TeoMouse/Electronic-Load-Project/3_ProductionFiles/BOM/Bill of Materials-Electronic_Load(Variant1).xlsx

Line # | Name | Description | Designator | Quantity | Value | Manufacturer 1 | Manufacturer Part Number 1 | Supplier Part Number 1
 | C0402 | Capacitor | C1_1, C1_2, C1_3, C1_4, C1_5, C1_6, C6_1, C6_2, C6_3, C6_4, C6_5, C6_6, C7_1, C7_2, C7_3, C7_4, C7_5, C7_6, C8_1, C8_2, C8_3, C8_4, C8_5, C8_6, C9_1, C9_2, C9_3, C9_4, C9_5, C9_6, C10, C18, C20, C21, C22, C24, C25, C26, C27, C31, C33, C36, C38, C39, C40, C41, C42, C43, C46 | 49 | 100nF/50V
 | C0402 | Capacitor | C4_1, C4_2, C4_3, C4_4, C4_5, C4_6, C14, C15, C16, C17 | 10 | 1uF/25V
 | C1206 | Capacitor | C11 | 1 | 2.2uF/100V
 | C0805 | Capacitor | C12, C13 | 2 | 22uF/25V
 | C0402 | Capacitor | C19 | 1 | 220pF/50V
 | C0603 | Capacitor | C23, C28, C29, C30, C32 | 5 | 10uF/25V
 | C0402 | Capacitor | C34, C35 | 2 | 12pF/25V
 | C0402 | Capacitor | C37 | 1 | 10nF/50V
 | C0805 | Capacitor | C44 | 1 | 100nF/50V
 | C0402 | Capacitor | C45 | 1 | 100pF/50V
 | V | LED | D2 | 1 |  | Wurth Electronics | 150060GS75000 | 710-150060GS75000
 | Schottky | Schottky Diode | D3 | 1 | S110FA |  |  | 512-S110FA
 | 100Ohms |  | FB1, FB2 | 2 |  | Wurth Electronics | 742792620 | 710-742792620
 | 74404064680 | Inductor 68 uH 1A Wurth Elektronic | L1 | 1 |  | Wurth Electronics | 74404064680 | 710-74404064680
 | Con 2x5.08 mm Screw |  | P1, P2 | 2
 | 1x2 2.54mm Straight Con |  | P3, P4, P5, P6, P7, P8, P9 | 7 |  | Eaton | NRL1104J3435B2F | 504-NRL1104J3435B2F
 | Screw_Pad_3mm |  | P10, P11 | 2
 | TO-247 Mos | MOSFET (N-Channel) | Q1_1, Q1_2, Q1_3, Q1_4, Q1_5, Q1_6 | 6 |  | Infineon | IRFP150NPBF | 942-IRFP150NPBF
 | PMV450ENEAR | MOSFET (N-Channel) | Q2 | 1 |  | Nexperia | PMV450ENEAR | 771-PMV450ENEAR
 | R0402 | Resistor | R1_1, R1_2, R1_3, R1_4, R1_5, R1_6, R12_1, R12_2, R12_3, R12_4, R12_5, R12_6, R14_1, R14_2, R14_3, R14_4, R14_5, R14_6, R18, R24, R56 | 21 | 1k
 | R0402 | Resistor | R2_1, R2_2, R2_3, R2_4, R2_5, R2_6, R3_1, R3_2, R3_3, R3_4, R3_5, R3_6, R5_1, R5_2, R5_3, R5_4, R5_5, R5_6, R13_1, R13_2, R13_3, R13_4, R13_5, R13_6, R21 | 25 | 100
 | R0402 | Resistor | R4_1, R4_2, R4_3, R4_4, R4_5, R4_6 | 6 | 2k
 | R0402 | Resistor | R6_1, R6_2, R6_3, R6_4, R6_5, R6_6, R28, R29, R34, R35, R51 | 11 | 10k
 | R0402 | Resistor | R7_1, R7_2, R7_3, R7_4, R7_5, R7_6 | 6 | 360
 | Rshunt_200m | Resistor | R8_1, R8_2, R8_3, R8_4, R8_5, R8_6, R9_1, R9_2, R9_3, R9_4, R9_5, R9_6 | 12 | 0R2 | Bourns | CRG2512-FZ-R200E-1 | 652-CRG2512FZR200E-1
 | R0402 | Resistor | R10_1, R10_2, R10_3, R10_4, R10_5, R10_6 | 6 | 22
 | R0402 | Resistor | R11_1, R11_2, R11_3, R11_4, R11_5, R11_6, R15_1, R15_2, R15_3, R15_4, R15_5, R15_6 | 12 | 5.6k
 | R0402 | Resistor | R16, R38, R39, R44, R45 | 5 | 118k
 | R0402 | Resistor | R17 | 1 | 22.1k
 | R0805 | Resistor | R19, R20, R22, R23 | 4 | 10 k
 | R0402 | Resistor | R25, R26 | 2 | 33R
 | R0402 | Resistor | R27, R32, R36 | 3 | 2.2k
 | Trimmer |  | R30 | 1
 | R0402 | Resistor | R31 | 1 | 500R
 | R0402 | Resistor | R33, R37 | 2 | 0R
 | R0402 | Resistor | R40, R41, R46, R47, R50, R52, R53, R54, R55 | 9 | 100R
 | R0402 | Resistor | R42, R43, R48, R49 | 4 | 100k
 | SW2x2 | Tactile Switches SPST OFF-(ON) Round pushbutton | SW1 | 1
 | TLV9061 |  | U1_1, U1_2, U1_3, U1_4, U1_5, U1_6, U6 | 7 |  | Texas Instruments | TLV9061SQDBVRQ1 | 296-TLV9061SQDBVRQ1CT-ND
 | NCS333A |  | U2_1, U2_2, U2_3, U2_4, U2_5, U2_6 | 6 |  | ON Semiconductor | NCS333ASN2T1G | 863-NCS333ASN2T1G
 | LMR51610 |  | U3 | 1 |  | Texas Instruments | LMR51610XDBVR | 595-LMR51610XDBVR
 | REF3030AIDBZR |  | U4 | 1 |  | Texas Instruments | REF3030AIDBZR | 595-REF3030AIDBZR
 | AP2112K-3.3TRG1 |  | U5 | 1 |  | Diodes | AP2112K-3.3TRG1 | 621-AP2112K-3.3TRG1
 | TMS320F280025C_LQFP48 |  | U7 | 1 |  | Texas Instruments | F280025CPTSR | 595-F280025CPTSR
 | 1x6 2.54mm St_Con_Fem |  | U8 | 1
 | TPS3702CX33DDCR |  | U9 | 1 |  | Texas Instruments | TPS3702CX33DDCR | 595-TPS3702CX33DDCR
 | LMV324 |  | U10 | 1 |  | Texas Instruments | LMV324AIPWR | 595-LMV324AIPWR
 | ECS-200-8-30B-CKM | 20MHz crystal oscillator | Y1 | 1 |  | ECS International | ECS-200-8-30B-CKM | 520-200-8-30B-CKM
