TeoMouse/Electronic-Load-Project/Test_Report/ElecLoad_DocumentationAndTestReport.xlsx

Sheet: Load Operation Description
UART Command | Description | Load Response
&ModeI; | Configure the electronic load to constant current mode (defaul mode) | Constant Current mode is active. | Load Maximum and minimum allowed electrical values.
&ModeR; | Configure the electronic load to constant resistance mode | Constant Resistance mode is active. | Variable | Minimum Value | Maximum Value
&ModeP; | Configure the electronic load to constant power mode | Constant Power mode is active. | Load Current | 0 | 30 A
&current xx.xx; | Set the reference value (xx.xx) for the constant current mode | No response | Load Resistance | 0,1 Ohms | 10000 Ohms
&resistor xx.xx; | Set the reference value (xx.xx) for the constant resistance mode | No response | Load Power | 0 W | 320 W
&power xx.xx; | Set the reference value (xx.xx) for the constant power mode | No response | Load Voltage | 0 V | 50 V
&FanEN; | The cooling fan of the load is enabled | Fan is enabled. | Note: in case of a user fault everything is also limited in the firmware
&FanDIS; | The operation of the fan is controlled by the reading values of the thermocouples. | Fan is automatically controlled.
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
