TeoMouse/Electronic-Load-Project/2_Schematic Documents/ProjecctSchematics.PDF

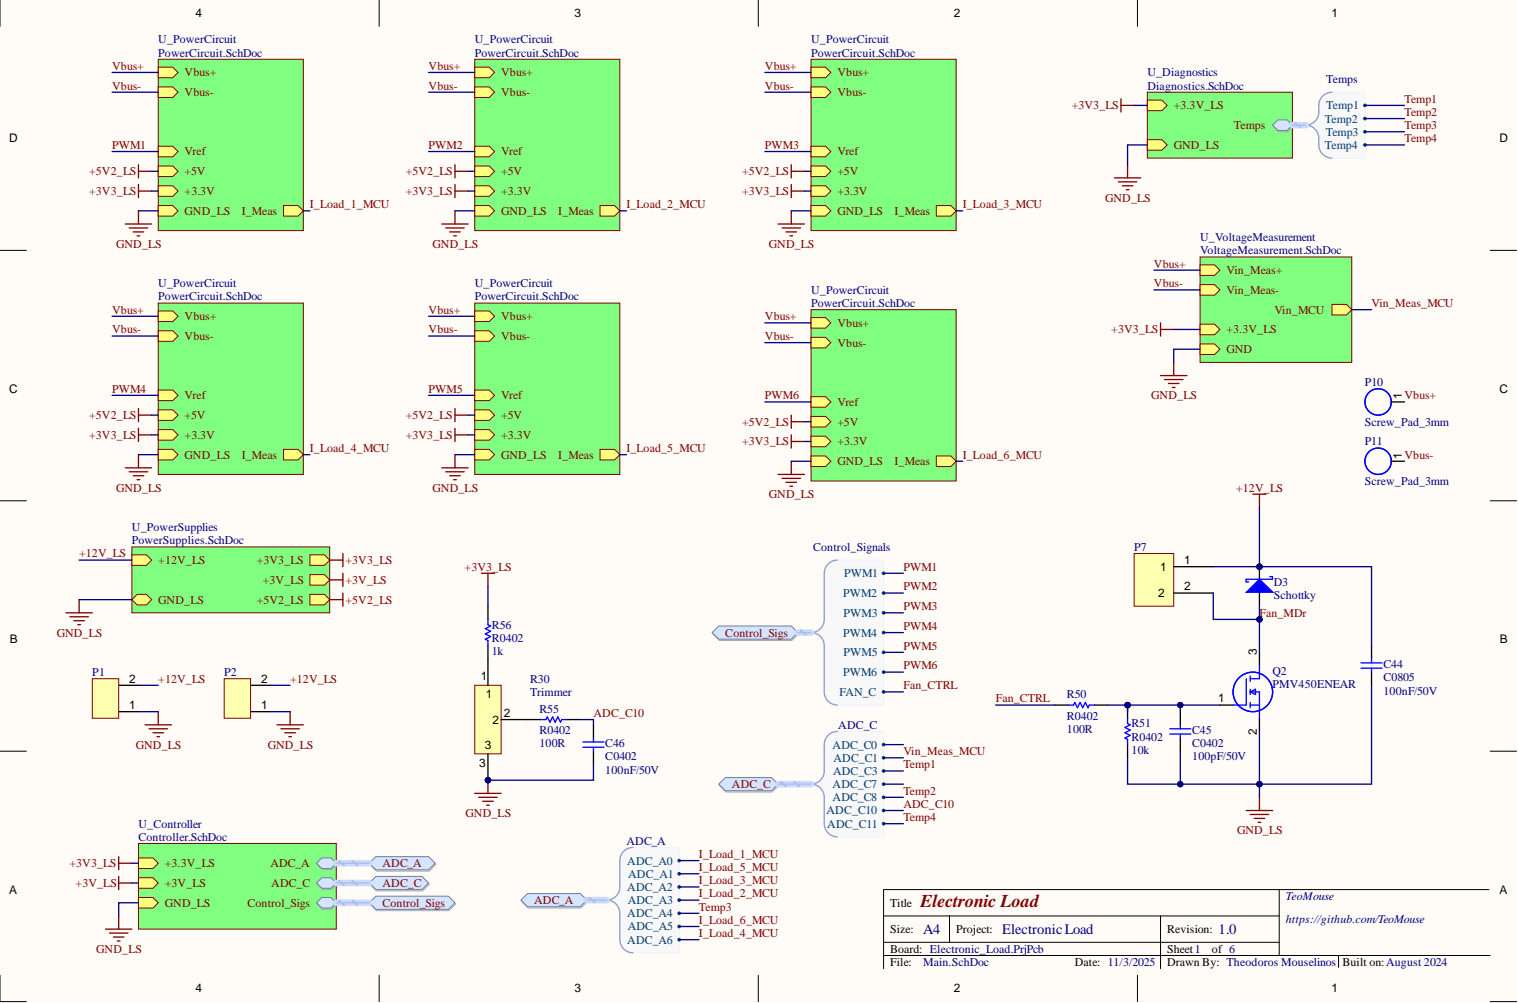
[picture p1: page 1]

https://github.com/TeoMouse

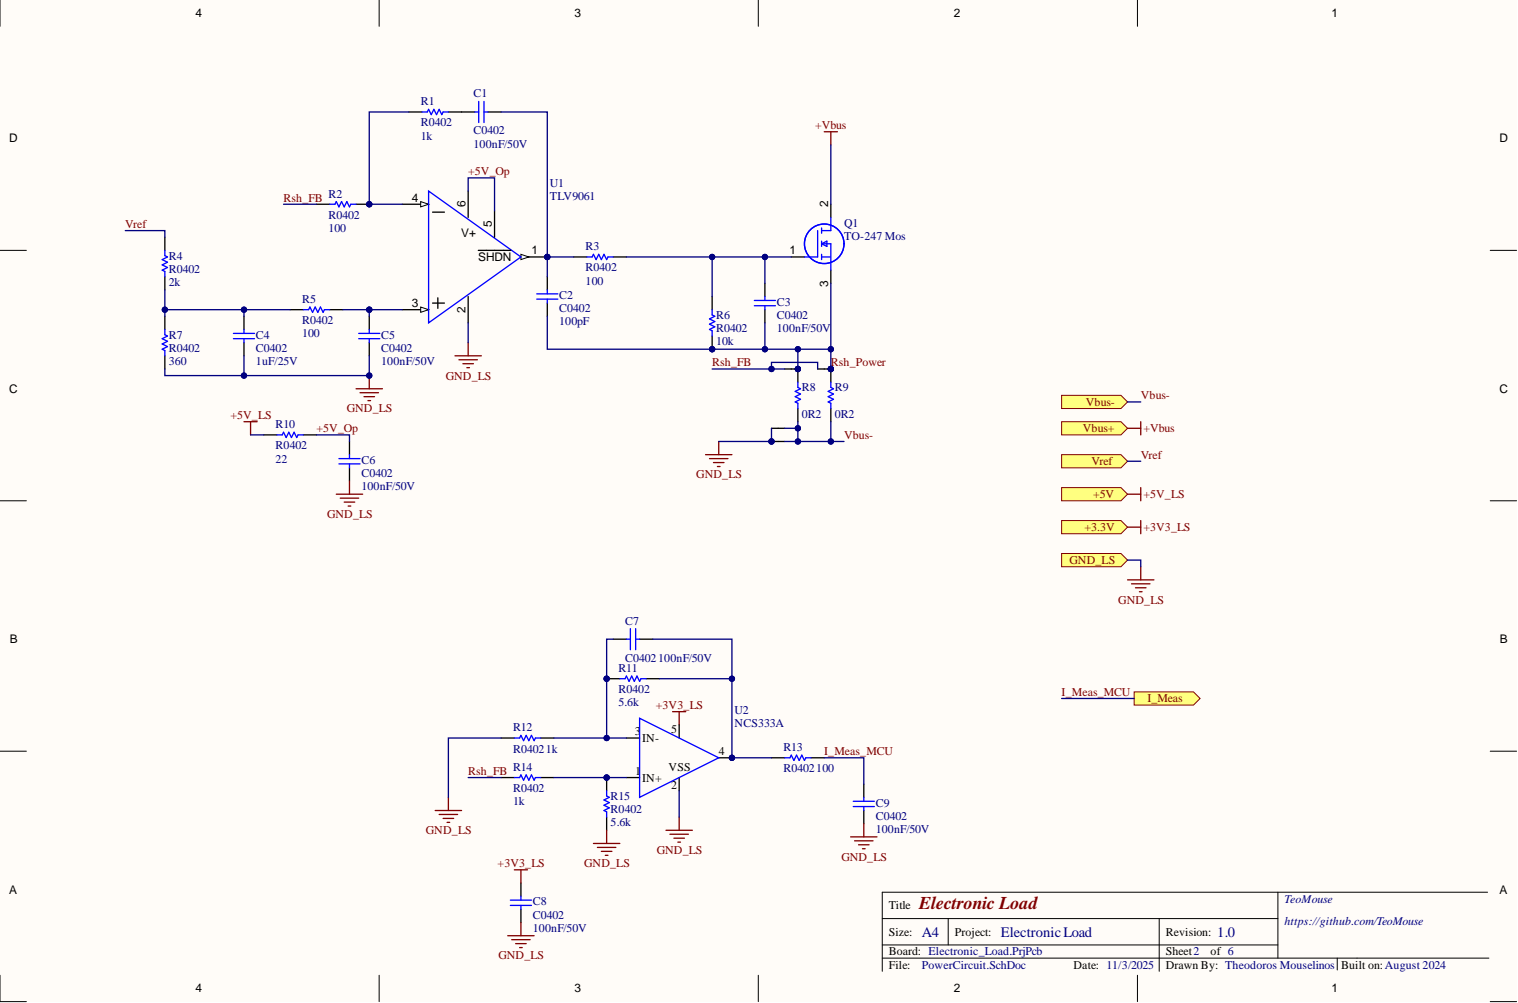
[picture p2: page 2]

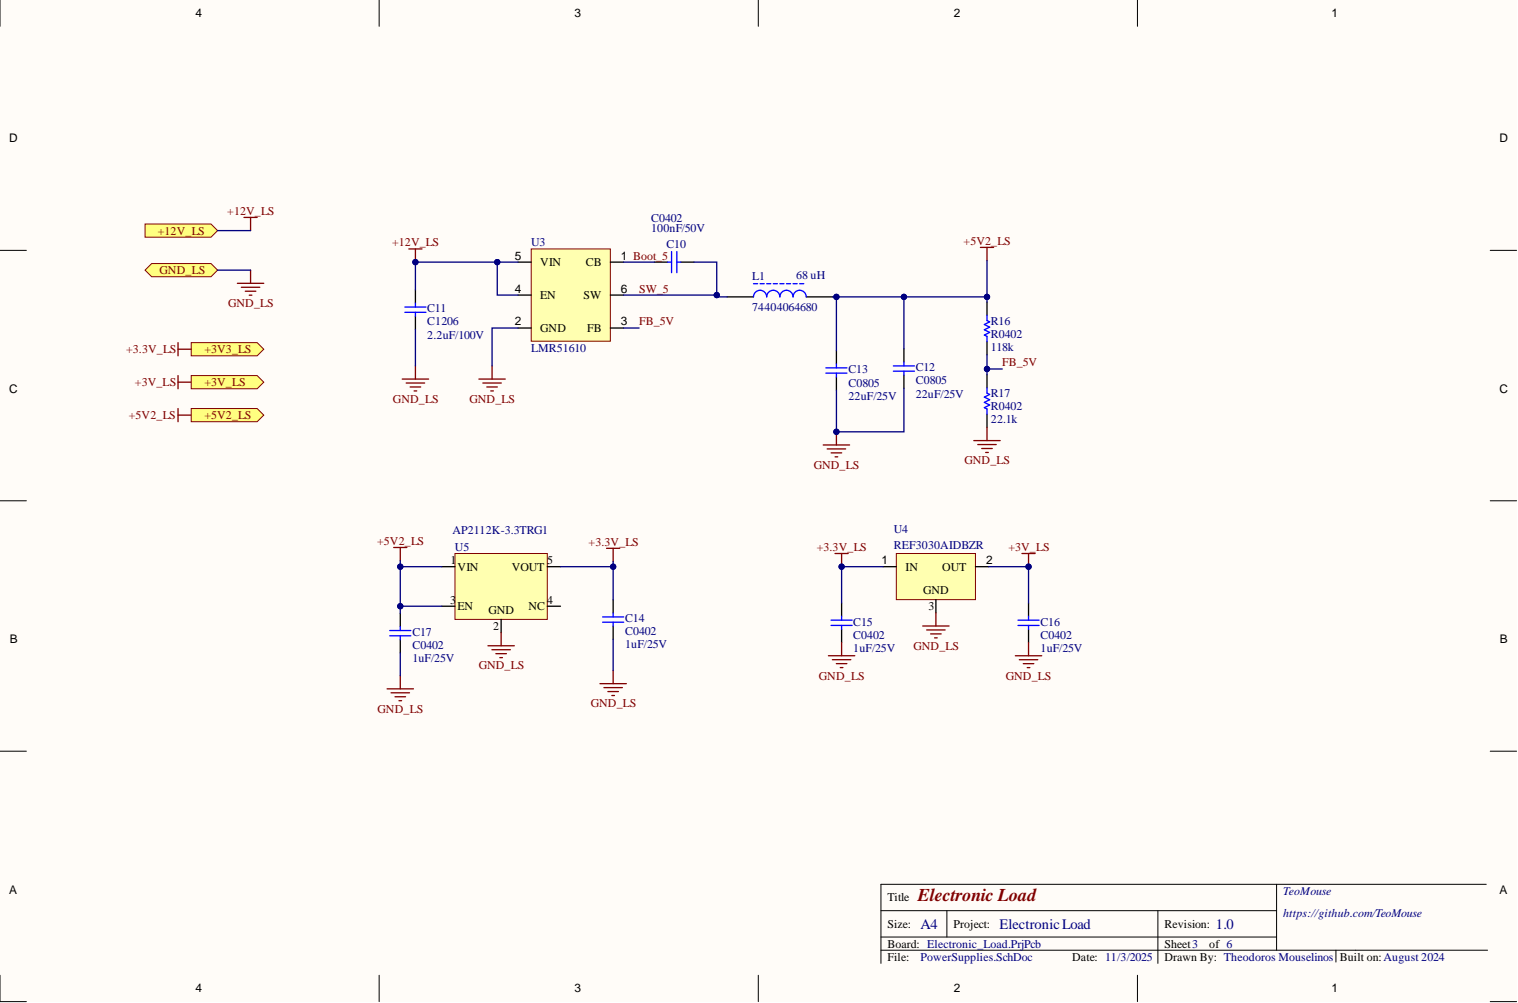
[picture p3: page 3]

https://github.com/TeoMouse

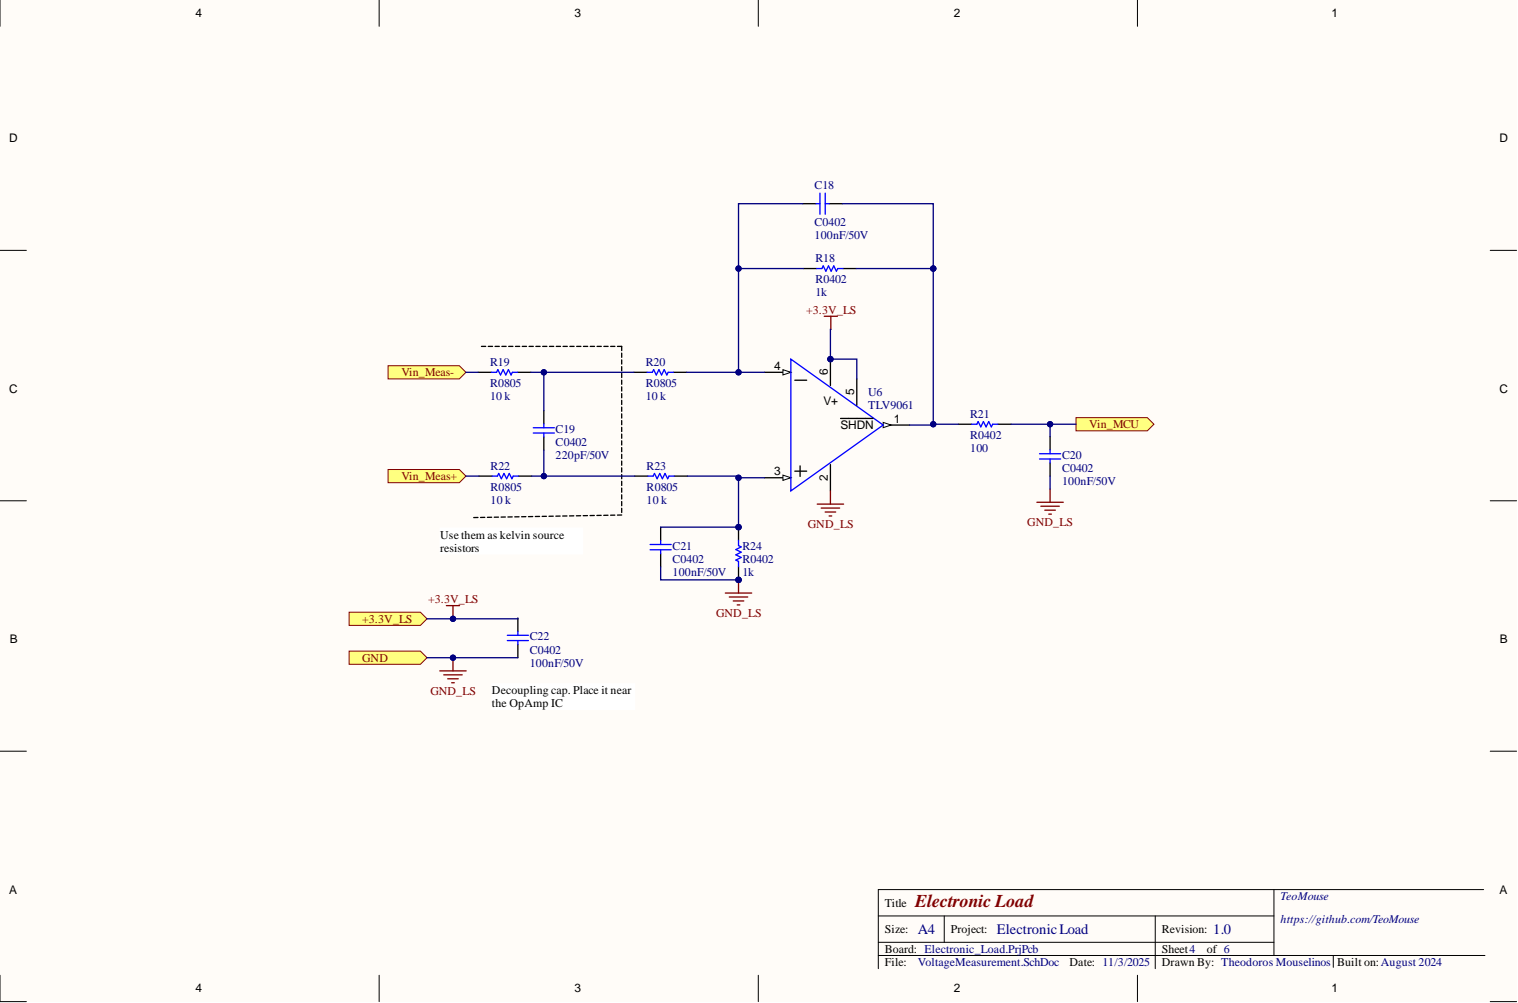
[picture p4: page 4]

Use them as kelvin source
resistors

Decoupling cap. Place it near
the OpAmp IC

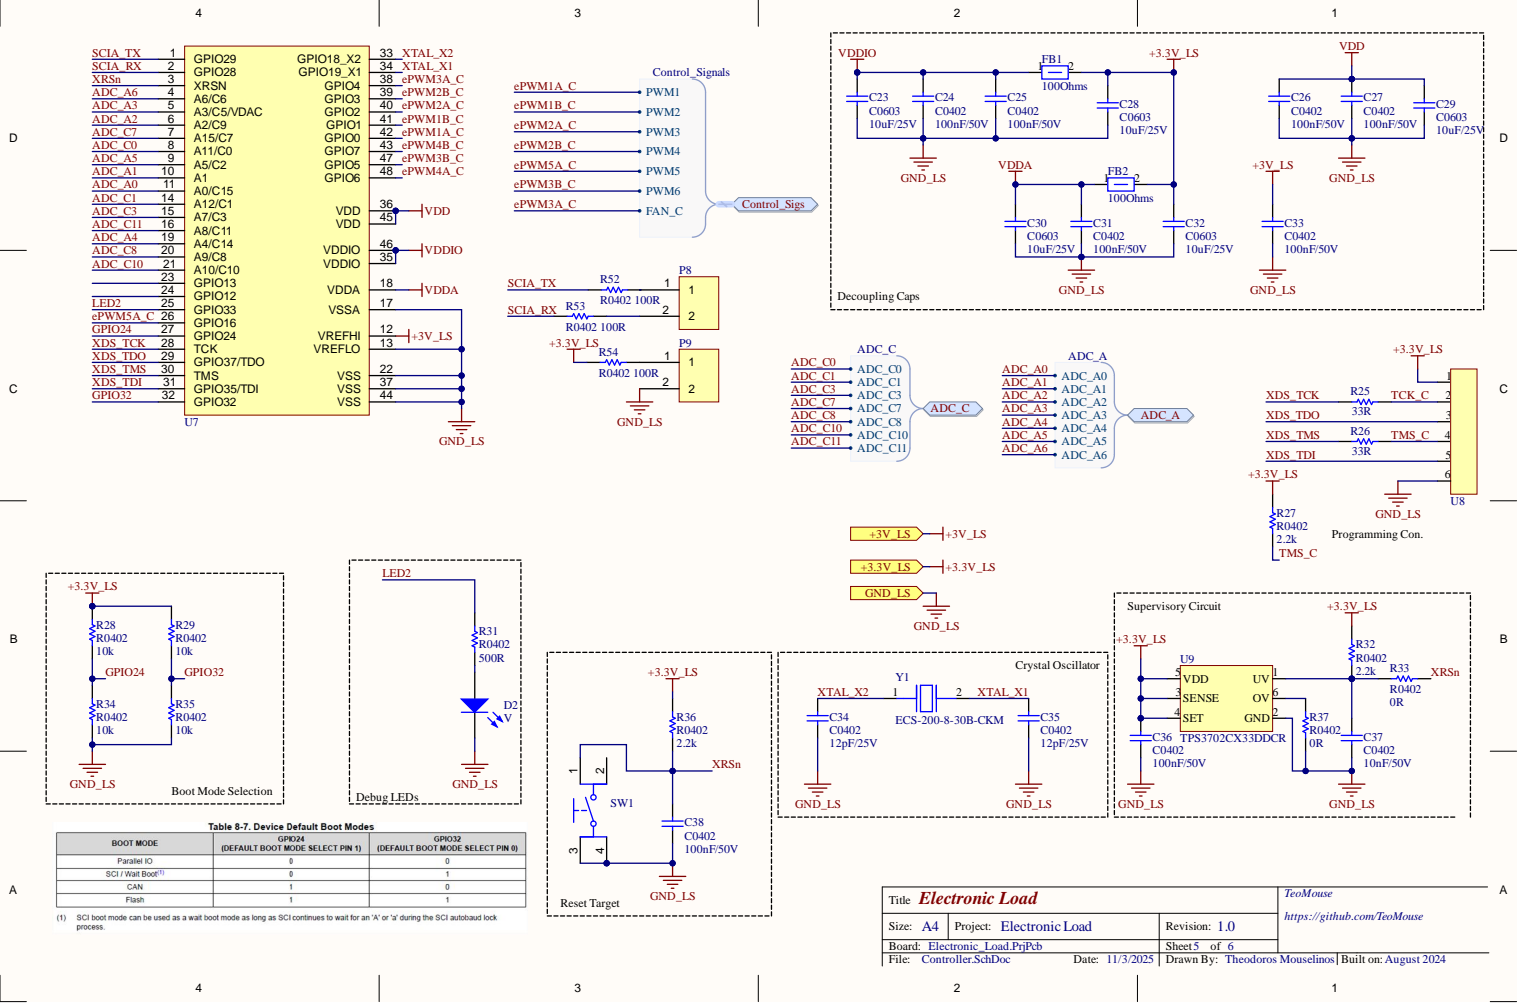
[picture p5: page 5]

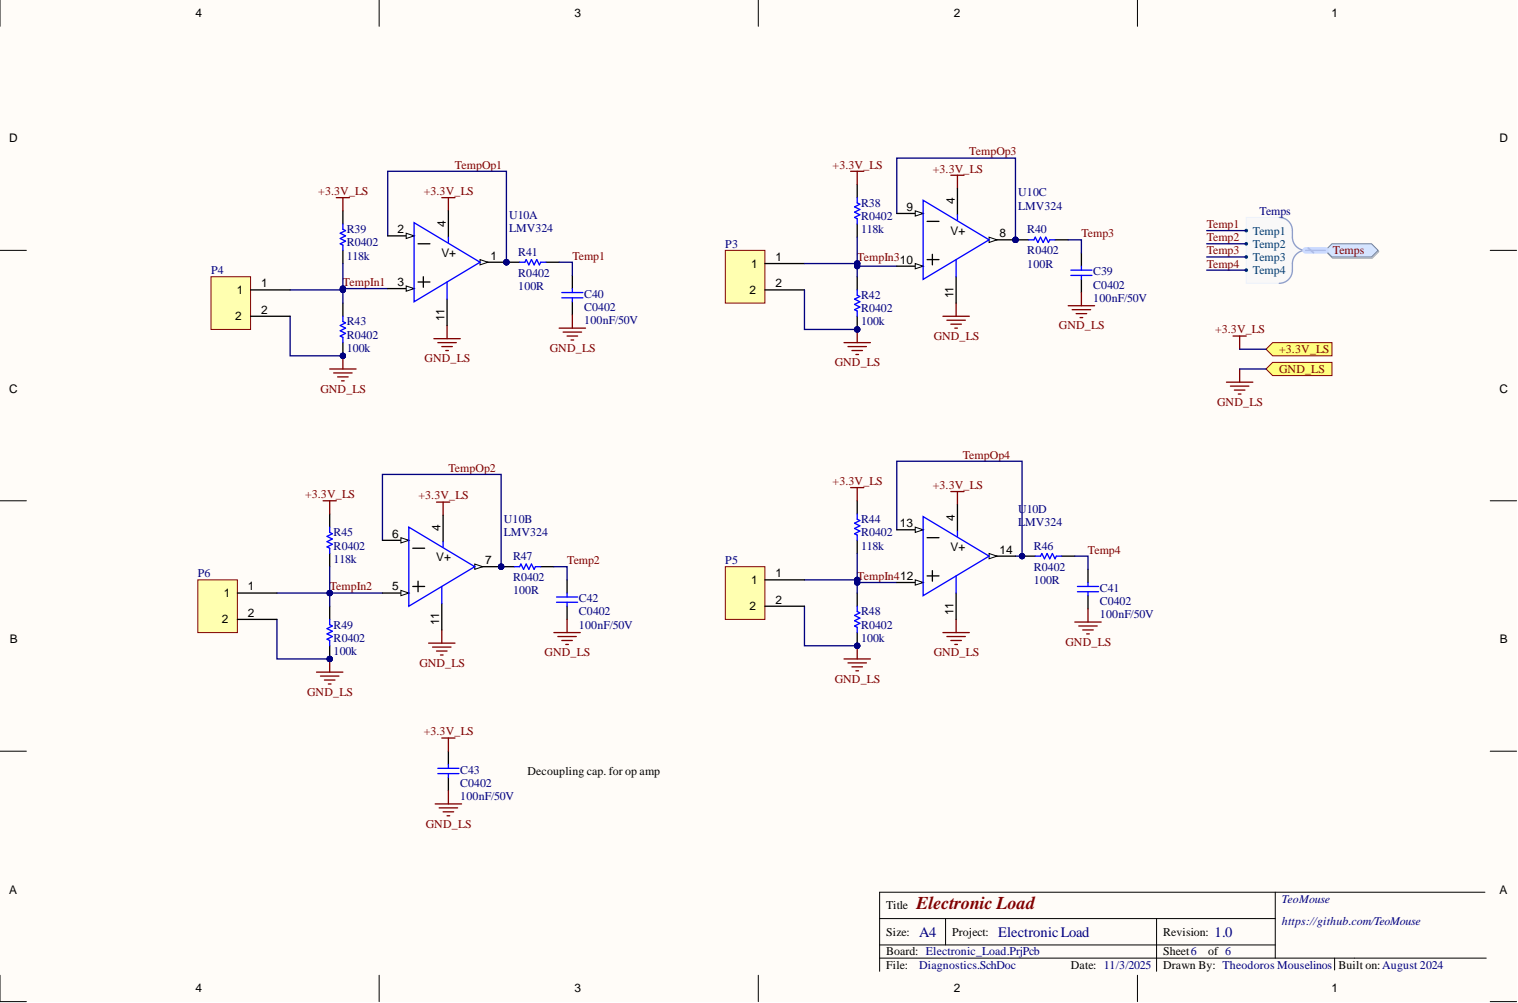
[picture p6: page 6]

Decoupling cap. for op amp
